3araht/giabalanai/readme.md

<p align=center>
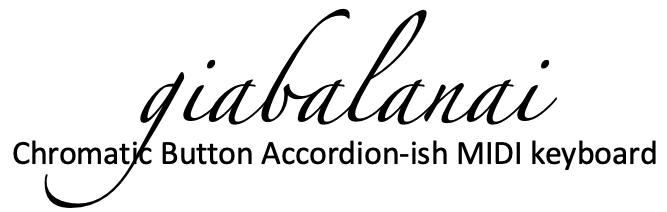
[picture p1: pictures/giabalanai_logo.png]
giabalanai_logo

</p>

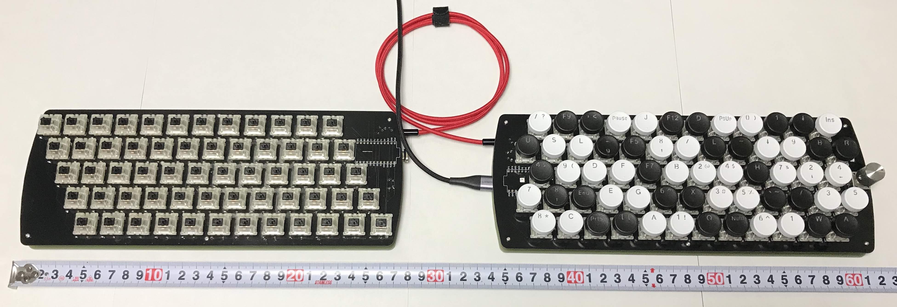
[picture p2: pictures/giabalanai_overview.jpg]
giabalanai overview


# giabalanai キーボード

✳︎ こちらは Pro Micro 版の giabalanai シリーズについてのページです。 [Raspberry Pi Pico 版の giabalanaipico シリーズにはこちら](https://github.com/3araht/giabalanaipico)を参照ください。

giabalanai キーボードは蛇腹もレジスタスイッチも無いシンプルデザインのクロマチックボタンアコーディオンチックな MIDI キーボード （60 ベース + C-system 62 鍵 = 38 音） です。
giabalanai は PC / Mac / iPad / iPhone で動作します。
（Android でも動作するそうです。ELEKIT（イーケイジャパン）さん、情報シェアいただきありがとうございます。）

コネクタが Lightning タイプの iPad や iPhone で使う場合、下記に示すアダプターを使って電源供給しながら使えることを確認しています。
iPad や iPhone で giabalanai を使う場合には電源が必要ですので、必ず "[Lightning - USB 3カメラアダプタ](https://www.apple.com/jp/shop/product/MK0W2AM/A/)" をお使いください。
"Lightning - USBカメラアダプタ" では電源供給ができません。

なお、USB-C タイプの iPad Air 4th Gen で試したところ、電源供給なしに問題なく動作させることができました。

ロータリーエンコーダは長押しでモード切り替えレイヤーへ。短押しでミュート切り替え、回転させるとシステム音量の調整に使用することが可能です。

# 外観および使用例
これらの動画 ([video1](https://youtu.be/EOIqms4lRcw), [video2](https://youtu.be/-KNHJdDH71s)) をご覧ください。

[こちら](https://youtu.be/hDas2LR00f4) は蛇腹談義のジングル(https://www.youtube.com/watch?v=WSVRJk6kDiM) を弾こうとしている様子です。

[私の YouTube チャンネル](https://www.youtube.com/channel/UC0zYtYMoxb0P7S8DPAkl0zA/) も併せてご覧ください。

ユニゾン機能の演奏例をGHEIMさんがUPされています。[こちら](https://twitter.com/GHEIM_2236/status/1382292767863296003?s=20&t=EltwkhD1qZg6FOf8UqGBdw)をご覧ください。

# キーボードキット
## ラインナップ
全部で7通りのバリエーションがございます。

|名前 | 説明 |
|---|---|
| giabalanai | 左手側が60鍵（伴奏用）右手側が62鍵盤（C-System）＋ロータリーエンコーダーが取り付け可能なモデル。|
| giabaLEnai | giabalanai の右手側だけ版|
| giabaRInaix2 | giabalanai の左手側のキーボードを2つ連結したモデル。ロータリーエンコーダーはありませんが、120キー全てが独立しているので自由にキー配置を変更できます（ソフト変更必要）。バンドネオン奏者の方、クロマトーン を演奏される方にはお勧め。|
| giabaRInai | giabalanai の左手側だけ版。giabaLEnai 持っているけどやっぱり左手側も欲しいという方向け。|
| giabalanaipico | giabalanai の Raspberry Pi Pico 版。右手側鍵盤が全て独立しました。また、レジスタスイッチも使えるようになりました。|
| giabaLEnaipico | giabalanaipico の右手側だけ版|
| giabaRInaipico | giabalanaipico の左手側だけ版。giabaLEnaipico 持っているけどやっぱり左手側も欲しいという方向け。|

giabalanai キーボードキットは遊舎工房さん、BOOTHでお求めいただけます。
[遊舎工房 販売ページへのリンクはこちら](https://yushakobo.jp/)。
遊舎工房さんでは、 [giabalanai](https://yushakobo.jp/shop/consign_giabalanai/) 、 [giabaLEnai](https://yushakobo.jp/shop/consign_giabalenai/) がお求めいただけます。

[BOOTH 販売ページへのリンクはこちら](https://3araht.booth.pm/)。
BOOTH では、全てお求めいただけます。

# ファームウェア

giabalanai は QMK firmware を使っています。下記からダウンロードできます:
[QMK - giabalanai directory](https://github.com/qmk/qmk_firmware/tree/master/keyboards/giabalanai)。

もしくは、こちらのコンパイル済の [hex file](https://github.com/3araht/giabalanai/blob/main/giabalanai_3araht_hex.zip) をお使いください （RGB_LIGHTING 有効）.

# ビルドガイド

[日本語ビルドガイド](https://github.com/3araht/giabalanai/blob/main/docs/build.md)

# コンタクト先:
Twitter と YouTube はじめました。
http://twitter.com/3araht
https://www.youtube.com/channel/UC0zYtYMoxb0P7S8DPAkl0zA/

## その他
#### giabalanai の名前の由来
アコーディオンの蛇腹が無いところから来ています（ジャバラナイ）。
giabaLEnai （ジャバレナイ）　は蛇腹に加えて左手側キーボード（LEft）がないこと、giabaRInai （ジャバリナイ）は右手側キーボード（RIght）がないこと、giabaRInaix2 は giabaRInai の2つ版、ということを示しています。

一応先祖はイタリア出身という設定なので、イタリア語表記を使っています。
そのため、 *jabaranai* ではなく giabalanai になっています。
<!--- not jabaranai but giabalanai ジャバラナイの名前の由来 -->

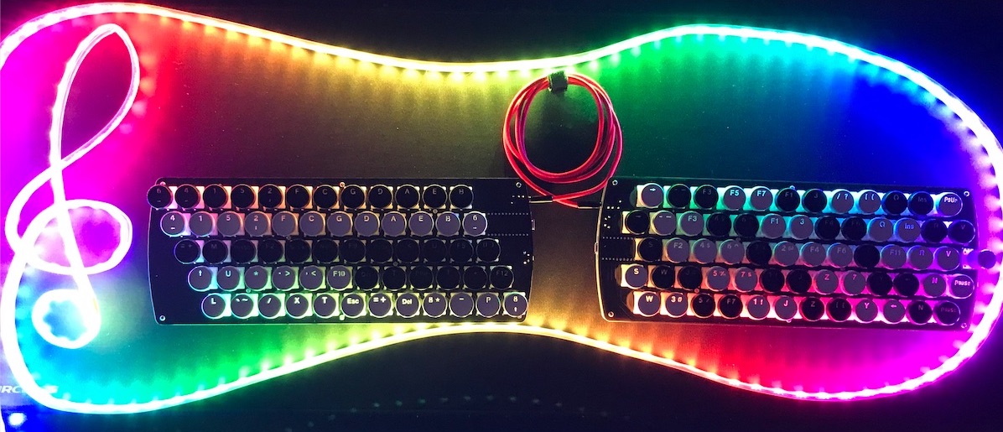
[picture p3: pictures/giabalanai_lighting2.jpg]
giabalanai lighting


# giabalanai keyboard

✳︎ This page is about giabalanai series, the Pro Micro version. For [giabalanaipico series, the Raspberry Pi Pico version, check here.](https://github.com/3araht/giabalanaipico)

giabalanai keyboard is a simple-design Chromatic Button Accordion-ish MIDI keyboard (60 bass + C-system 62 keys = 38 notes) that doesn't have bellows nor register switches.
giabalanai works with PC, Mac, iPad, and iPhone.
(It works with Android as well. Thanks to @elekit_official for sharing the info.)

When using it with iPad or iPhone, it works when the below adapter is used with a power supply. The power supply is necessary to use giabalanai on iPad and iPhone. Make sure to use "[Lightning to USB 3 Camera Adapter](https://www.apple.com/shop/product/MK0W2AM/A/)", not "Lightning to USB Camera Adapter."

It would work with [USB-C Digital AV Multiport Adapter](https://www.apple.com/shop/product/MUF82AM/A/) for the USB-C type iPads ~~( Since I don't have the latest iPad, it is not confirmed ).~~

(2021/04/08 added. Confirmed with an iPad Air 4th Gen, which has USB-C port, it worked without the power supply.)

A rotary encoder can be used to change the settings of giabalanai by long-pressing the push-button of the encorder, mute/unmute by clicking, and adjusting the system volume of your computer by rotating the encoder.

# How it looks & how it works
Check these short videos ([video1](https://youtu.be/EOIqms4lRcw), [video2](https://youtu.be/-KNHJdDH71s)) to see how it looks & how it works.

Here's another [video](https://youtu.be/hDas2LR00f4), trying to play (pardon my poor playing skills) a theme song of Giabala-Dangi (https://www.youtube.com/watch?v=WSVRJk6kDiM).

Check [my YouTube channel](https://www.youtube.com/channel/UC0zYtYMoxb0P7S8DPAkl0zA/) for more videos.

# Keyboard kit
## Lineup
There are total 7 types:

|Name | Notes |
|---|---|
| giabalanai | 60 keys on the left-hand side for playing chords and 62 keys ＋ optional rotary encoder on the right-hand side for playing the melody (C-System)|
| giabaLEnai | The right-hand side only version of giabalanai |
| giabaRInaix2 | Two pcs of the left-hand side of giabalanai. Rotary Encoder is not applicable. All 120 keys are isolated, so there is more flexibility for customizing the key layout (software modification is required). Bandoneon and Chromatone players might be interested in this model.|
| giabaRInai | The left-hand side only version of giabalanai. For our friends who have giabaLEnai but want to have the left-hand side later on.|
| giabalanaipico | Raspberry Pi Pico version of giabalanai. All keys on the right side keyboard are now independent. Register switches are now available. |
| giabaLEnaipico |  The right-hand side only version of giabalanaipico |
| giabaRInaipico | The left-hand side only version of giabalanaipico. For our friends who have giabaLEnaipico but want to have the left-hand side later on.|

The keyboard kit is available from [Yushakobo](https://yushakobo.jp/shop/consign_giabalanai/), or from [BOOTH](https://3araht.booth.pm/).

Click [here](https://www.tenso.com/en/static/lp_shop_booth) for BOOTH overseas shipping!

Both [giabalanai](https://yushakobo.jp/shop/consign_giabalanai/) and [giabaLEnai](https://yushakobo.jp/shop/consign_giabalenai/)  are available from Yushakobo.
All the models are available from [BOOTH](https://3araht.booth.pm/).

# Firmware

The giabalanai uses QMK for its firmware. The codes for it is available here:
[QMK - giabalanai directory](https://github.com/qmk/qmk_firmware/tree/master/keyboards/giabalanai).

Or, use this pre-compiled [hex file](https://github.com/3araht/giabalanai/blob/main/giabalanai_3araht_hex.zip) for your convenience (RGB_LIGHTING enabled).

# Build Guide

[Japanese Build Guide](https://github.com/3araht/giabalanai/blob/main/docs/build.md)
Try [Google Translated guide](https://translate.google.com/translate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) for your language preferences. Trust me, it works quite well, more than expected.

# Contact
If you need any help, you know where to find me.
http://twitter.com/3araht
https://www.youtube.com/channel/UC0zYtYMoxb0P7S8DPAkl0zA/

## Miscellaneous
#### Origin of the name: giabalanai
When you pronounce giabalanai, it sounds like "蛇腹無い" in Japanese = *bellows-less*, which represents the keyboard.
Much easier for others: giabaLEnai = not only bellows-less but missing LEft-hand side, giabaRInai = not only bellows-less but missing RIght-hand side, and two sets of giabaRInai is giabaRInaix2.

Well, the ancestor of this keyboard is located in Italy ;-) so the Italian spelling method is used.
That's why it is not *jabaranai* but giabalanai.
<!--- not jabaranai but giabalanai ジャバラナイの名前の由来 -->
