3araht/giabalanai/docs/old/20200923.md

**お詫びと確認のお願い**  
2020/9/23 に、giabalanai キーボード キットをご購入いただいた方から、ダイオードの数が足りないとのご連絡をいただきました。
その方への不足分の発送、Twitterで今回の件についてのご報告、遊舎工房さんの在庫分の確認を行いました。
問題の可能性があるキットは、 9/18 〜 9/23 までにご購入された方のキットになります。9/23 に確認できた遊舎工房さんの在庫は問題なかったのですが、単純計算しますと確率的にもう 1 〜 2 セット同様の問題のセットが流出してしまった可能性がございます。
今回ご指摘下さった方にこの場で改めてご迷惑をおかけしたことをお詫び申し上げます。

また、9/18 〜 9/23 までにご購入された方皆様には、まず最初に員数の確認をお願い致します。
もし員数不足が見つかりましたら、まずは遊舎工房さんにご連絡ください。皆様の個人情報につきましては取り扱いに十分注意し、不足分を最短でお送りするように致します。
ご不便・ご迷惑おかけして申し訳ございません。どうぞよろしくお願い申し上げます。

今後の防止策と致しましては、タブルチェックの強化および予備の同梱により最悪員数が下振れしても必要数量を下回らないように致します。
