3araht/giabalanai/pictures/20200927_giabalanai_Colemak_layout.png

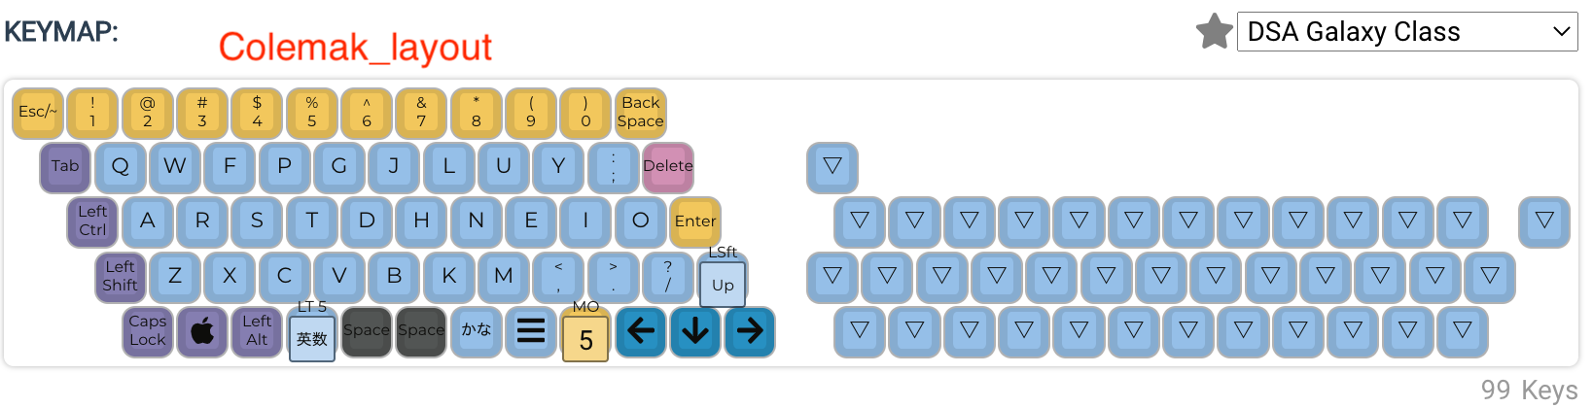
pictures/20200927_giabalanai_Colemak_layout.png
