3araht/giabalanai/pictures/20200927_giabalanai_FN_layer.png

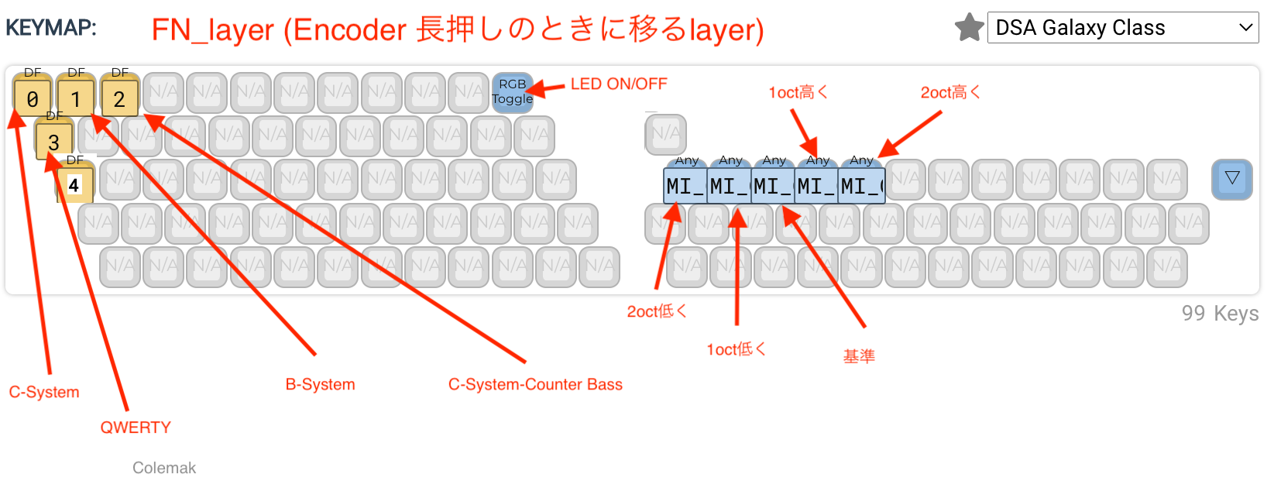
pictures/20200927_giabalanai_FN_layer.png
