3araht/giabalanai/pictures/20201130_giabalanai_FN_layer.png

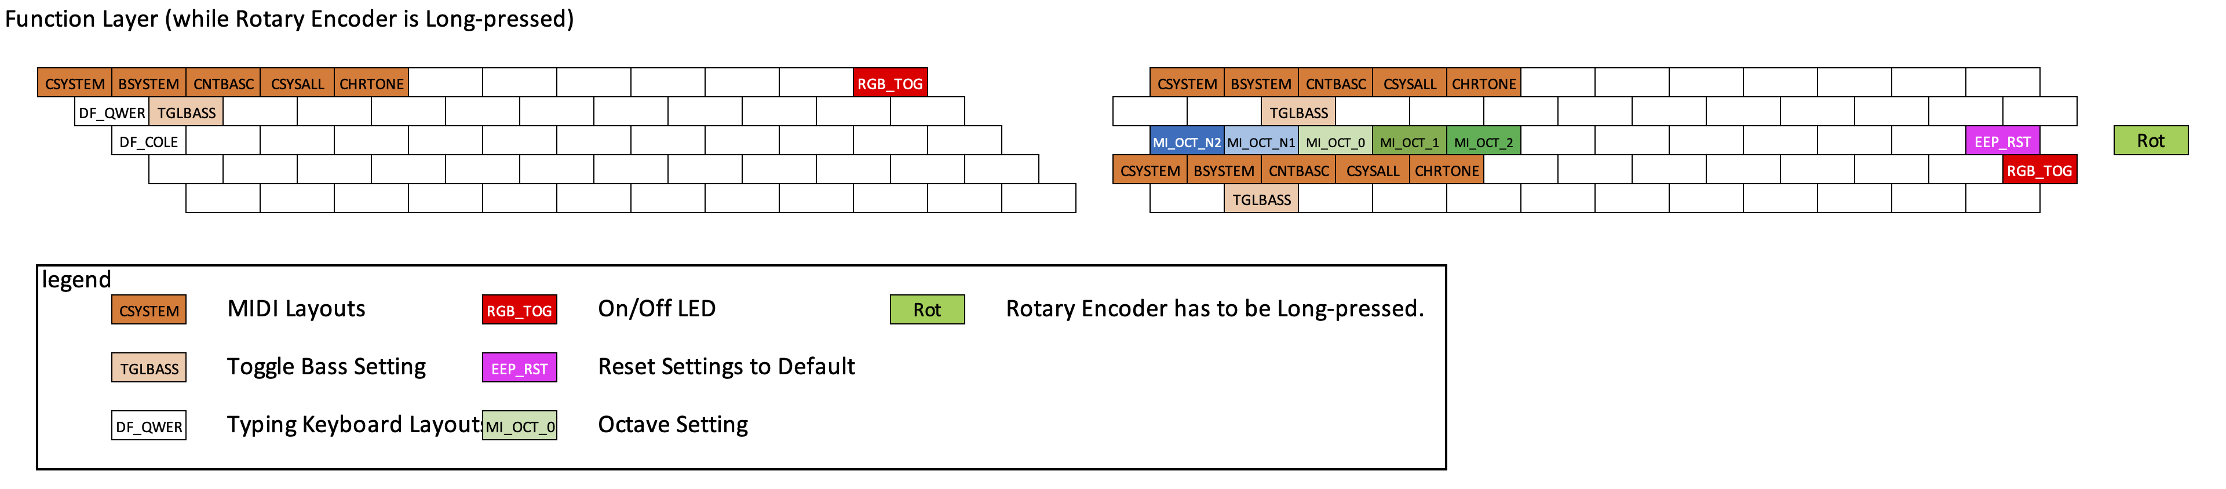
pictures/20201130_giabalanai_FN_layer.png
