3araht/giabalanai/pictures/20201130_giabalanai_notes_layout_3araht.png

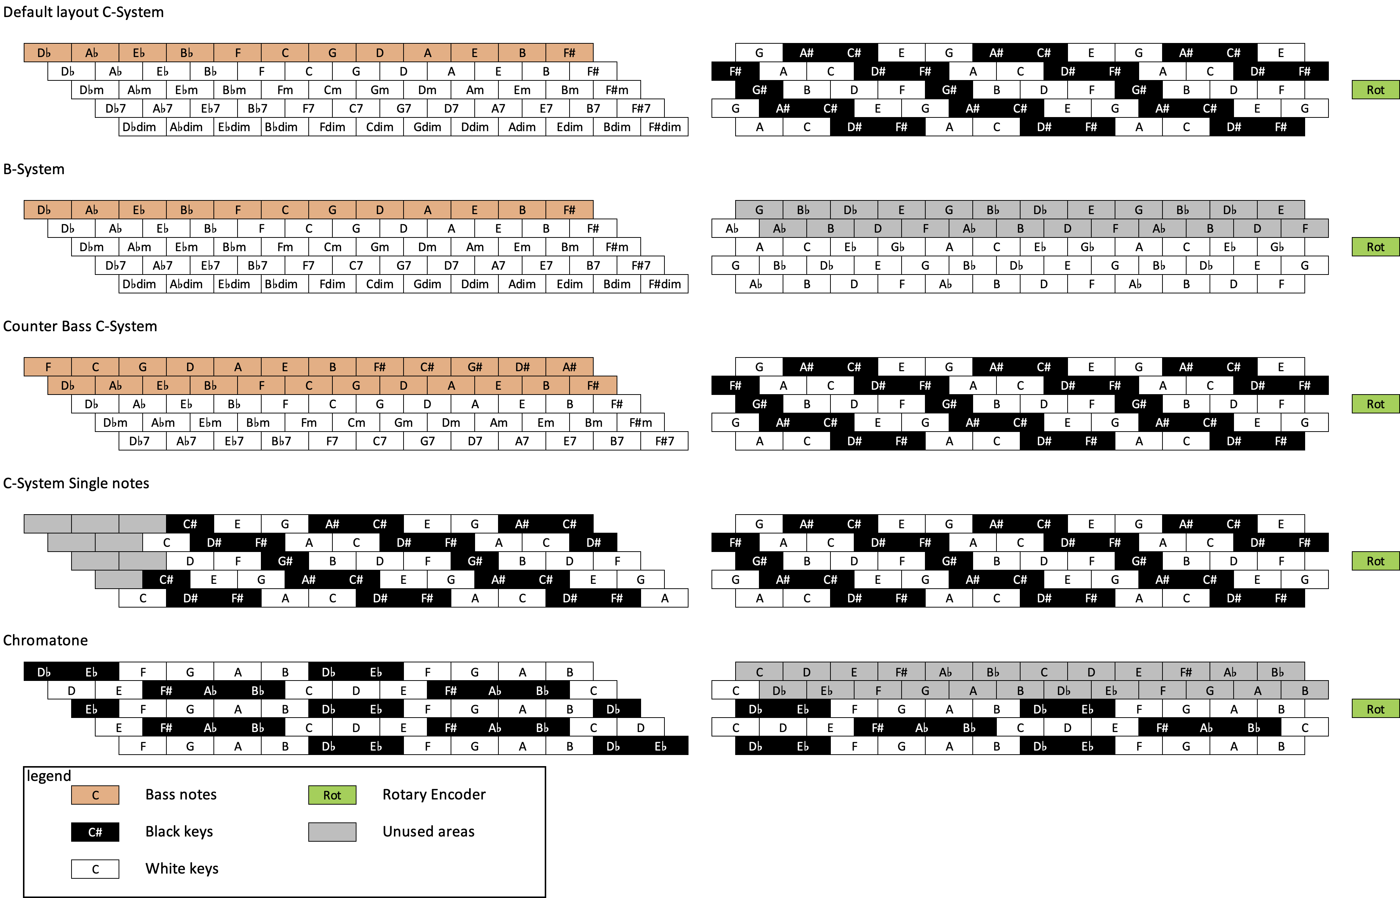
pictures/20201130_giabalanai_notes_layout_3araht.png
