3araht/giabalanai/pictures/20201205_giabalanai_FN_layer.png

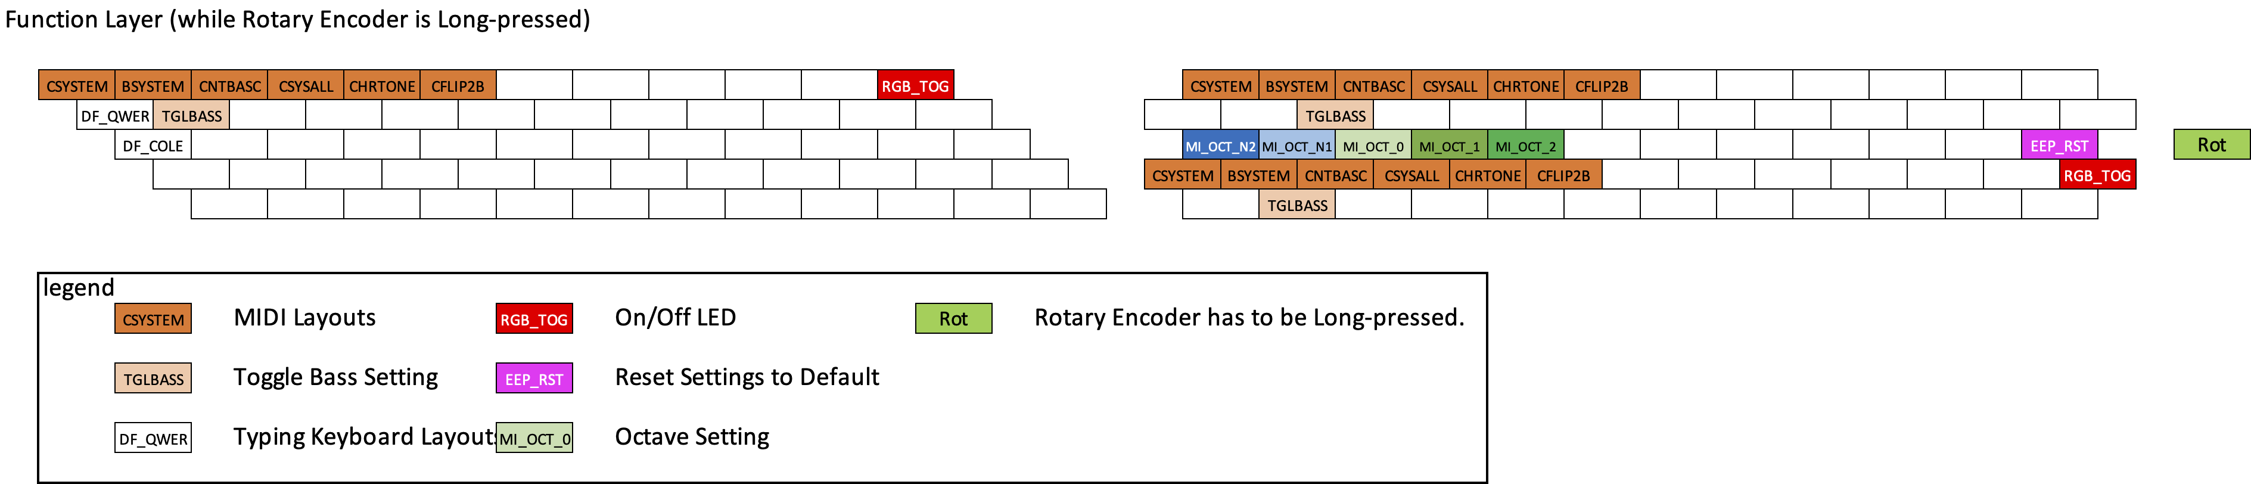
pictures/20201205_giabalanai_FN_layer.png
