3araht/giabalanai/pictures/20220220_giabalanai_FN_layer.png

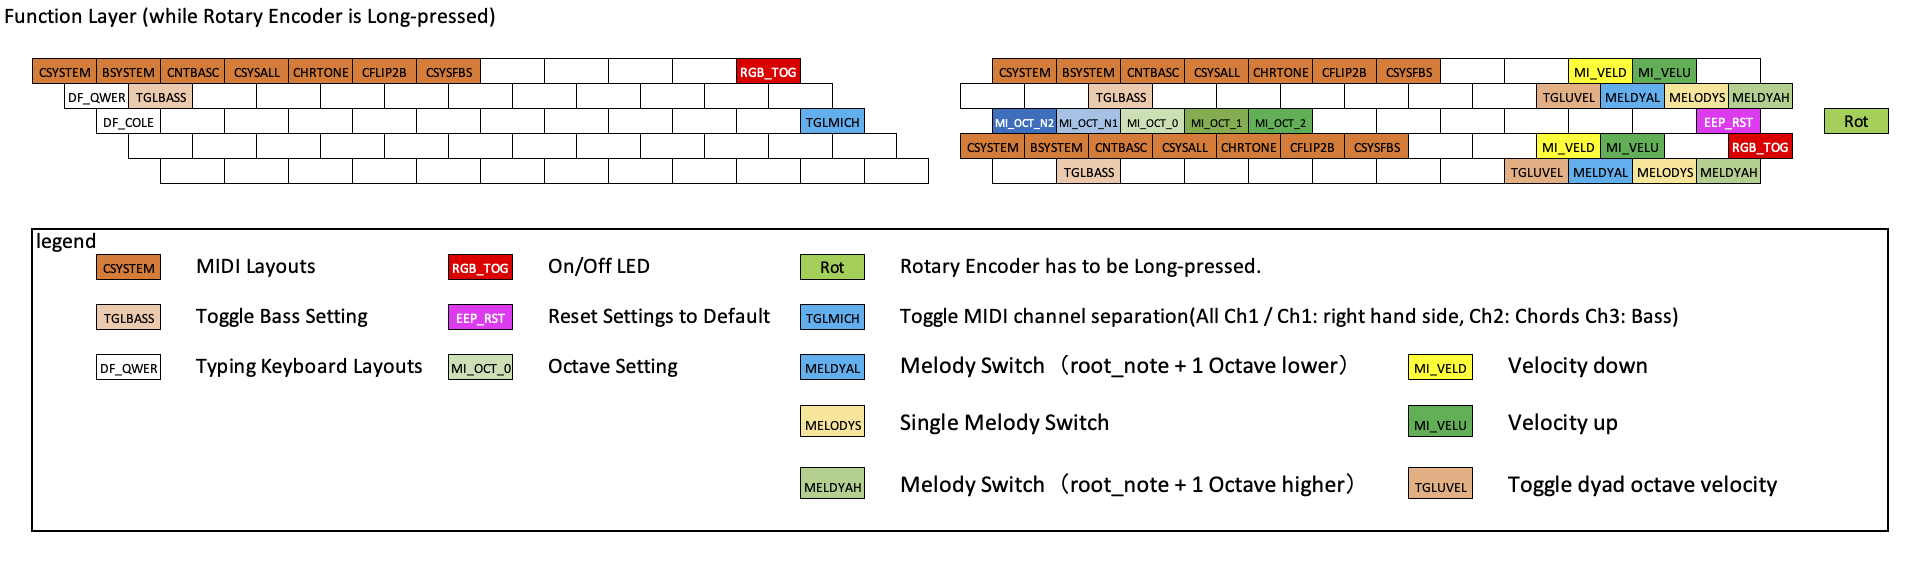
pictures/20220220_giabalanai_FN_layer.png
