3araht/giabalanai/pictures/20220220_giabalanai_notes_layout_3araht.png

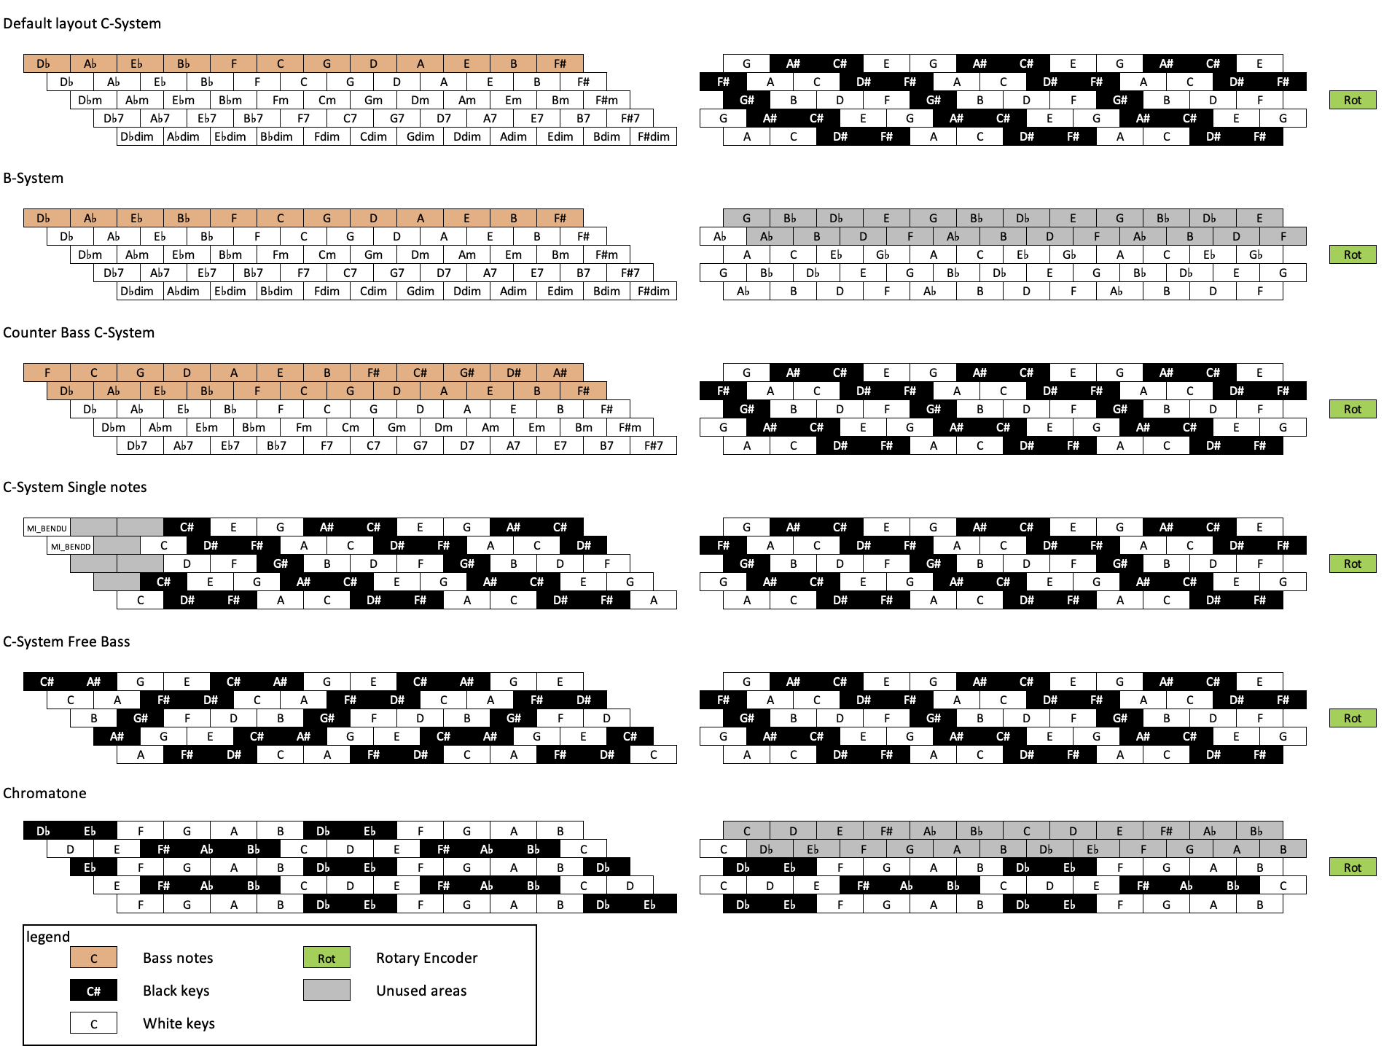
pictures/20220220_giabalanai_notes_layout_3araht.png
