3araht/giabalanai/pictures/20220807_giabalanai_FN_layer.png

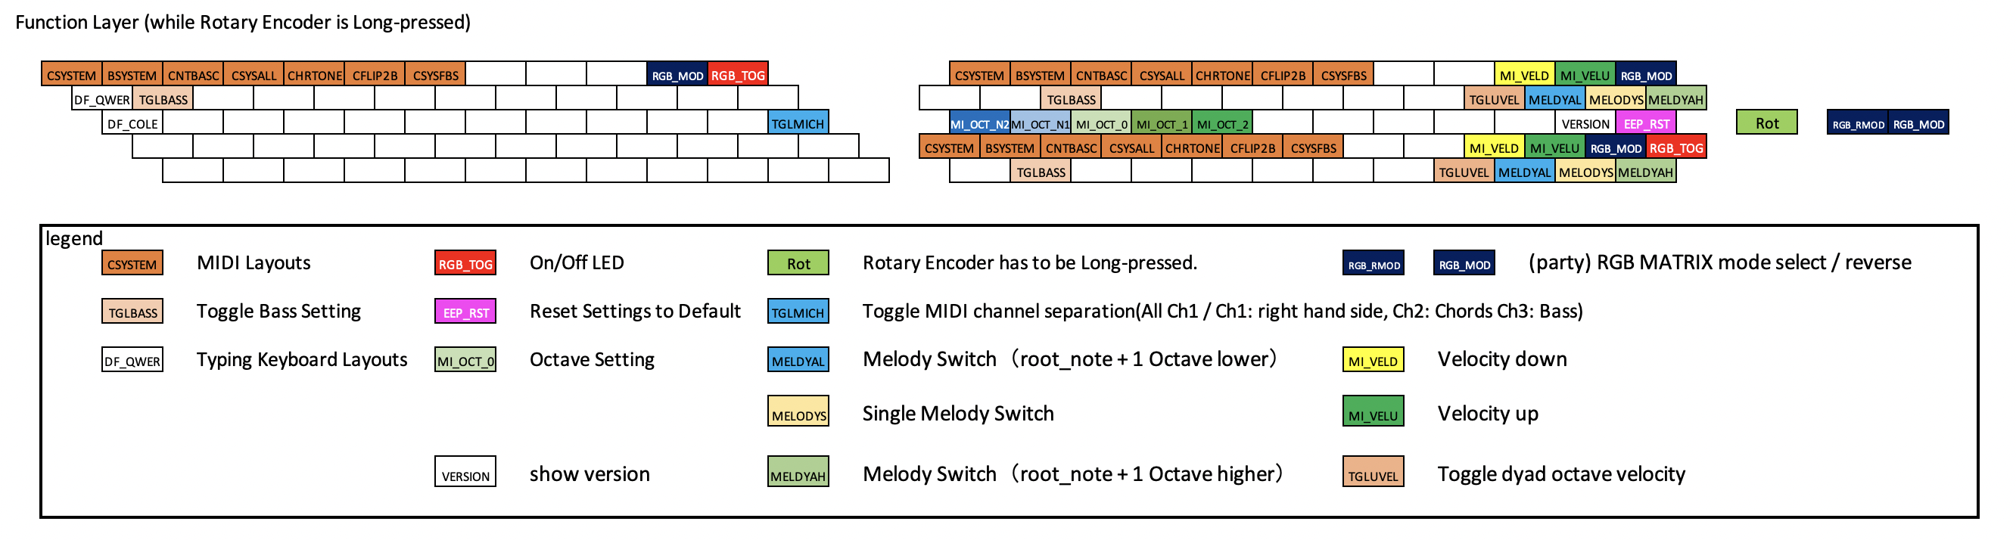
pictures/20220807_giabalanai_FN_layer.png
