3araht/giabalanai/pictures/giabalanai16_9.jpg

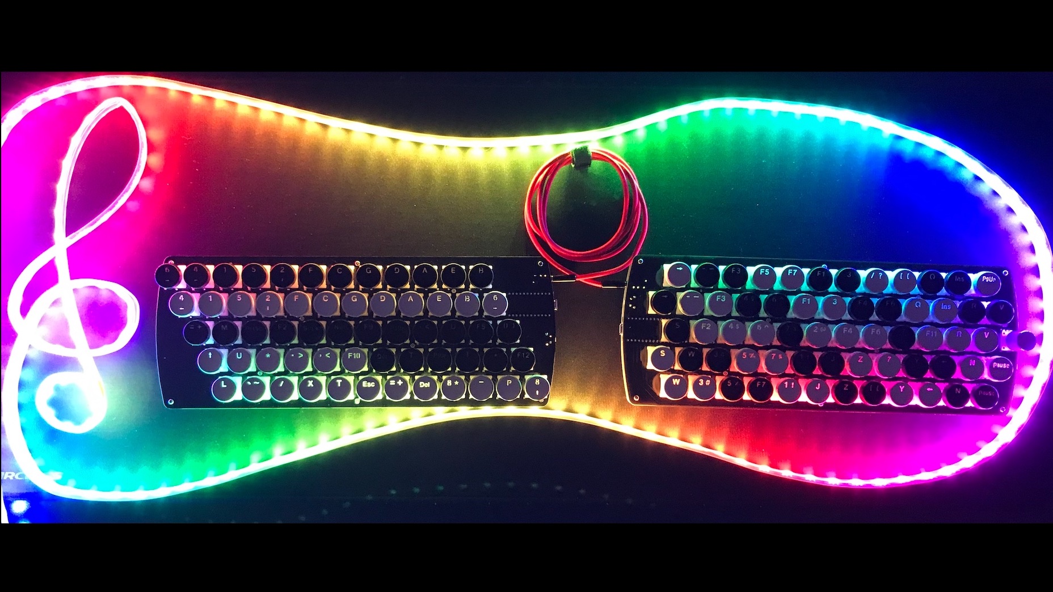
pictures/giabalanai16_9.jpg
