3araht/giabalanai/pictures/giabalanai_notes_layout_3araht.png

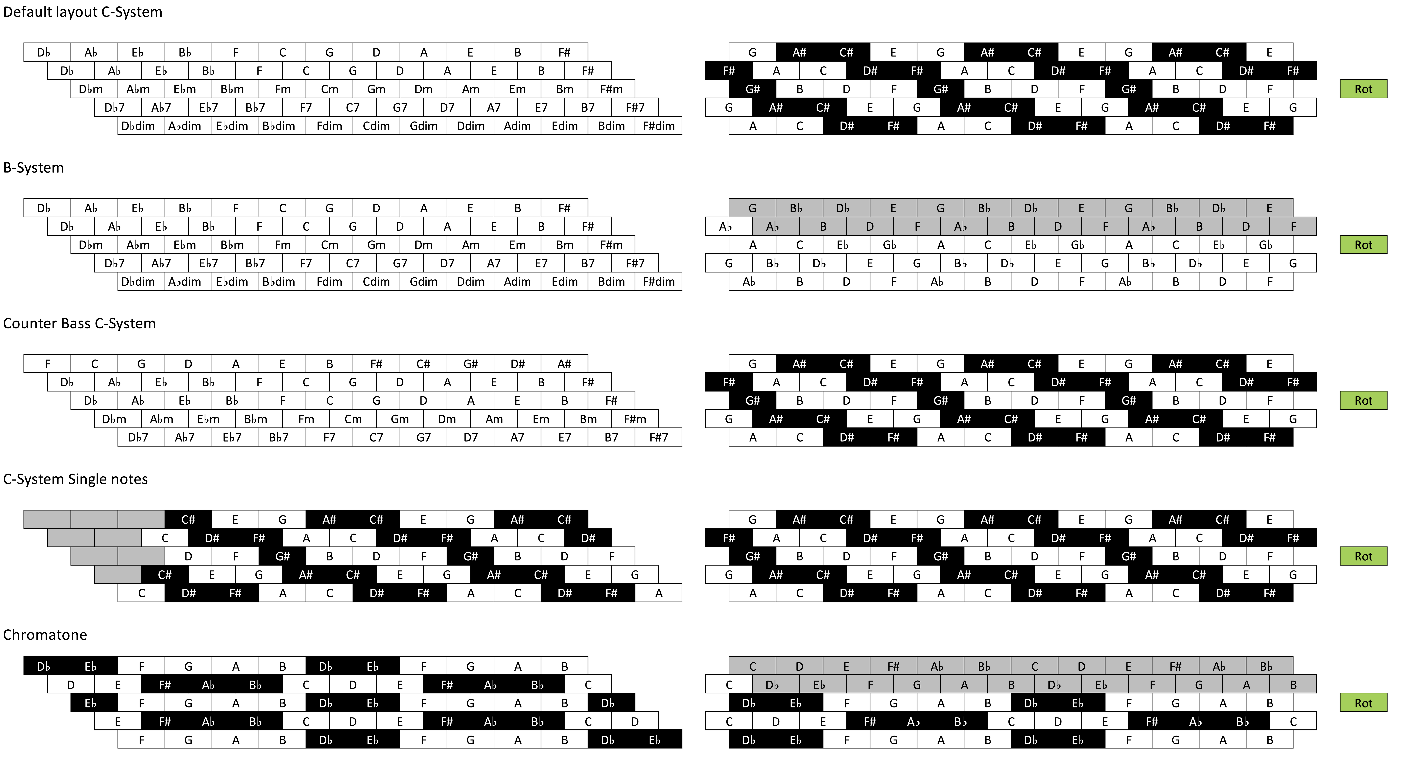
pictures/giabalanai_notes_layout_3araht.png
