3araht/giabalanai/pictures/giabalanai_overview_square.jpeg

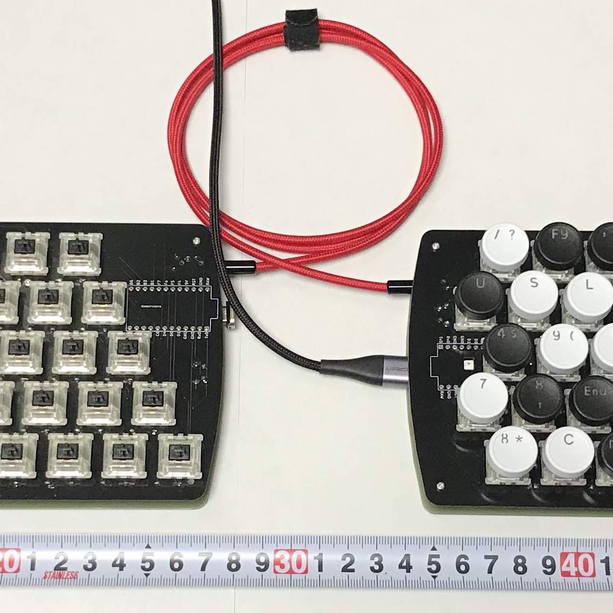
pictures/giabalanai_overview_square.jpeg
