3araht/giabalanai/pictures/giabaRInai_overview.jpeg

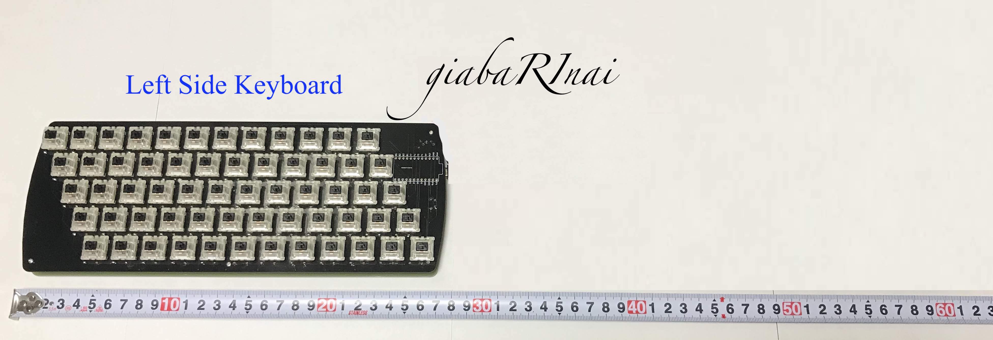
pictures/giabaRInai_overview.jpeg
