3araht/giabalanai/pictures/giabaRInaix2.jpeg

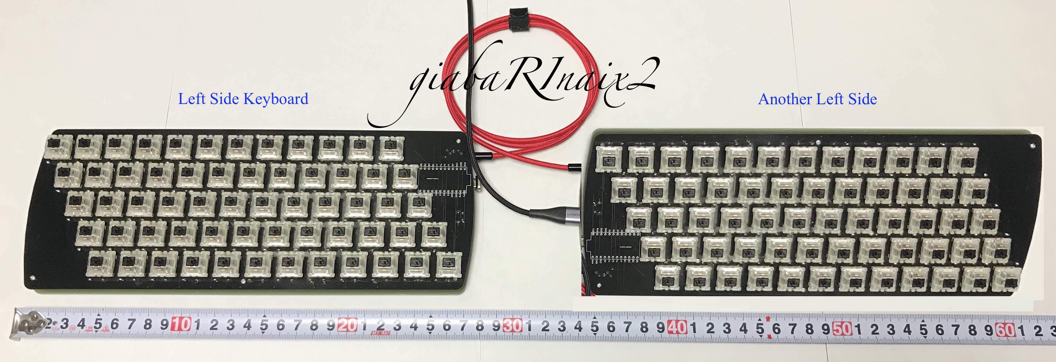
pictures/giabaRInaix2.jpeg
