3araht/giabalanai/pictures/hexDownload.png

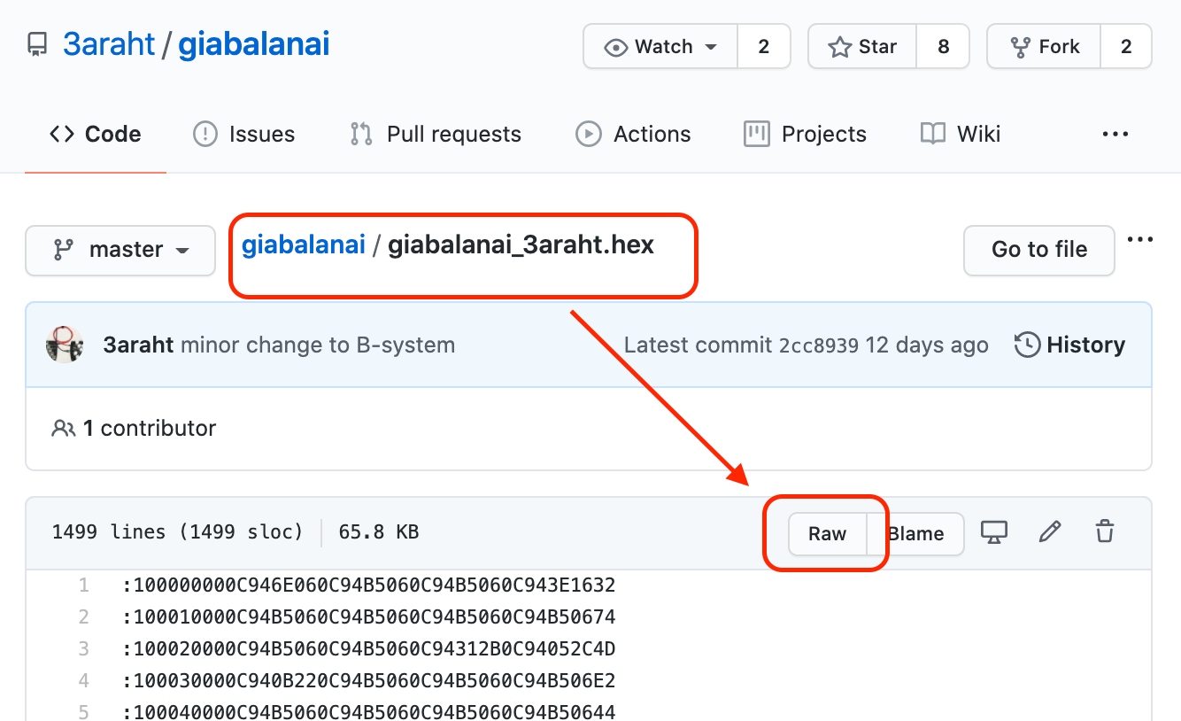
pictures/hexDownload.png
