3araht/giabalanai/docs/build_r01.md

# giabalanai Build Guide  〜 rev.01 用 〜
*rev.02用のビルドガイドは[こちら](https://github.com/3araht/giabalanai/blob/main/docs/build.md)*

**一度すべて読んでから組み立てることをお勧めします。**

## 0 パーツの確認、各部品の実装面の整理
### キット付属品

| パーツ名 |  個数  |  備考  |
|---|---|---|
|左手側基板|1枚|キーが平行四辺形に5行12列配置されているもの。|
|右手側基板|1枚|キーが上から12列、13列、12列、13列、12列配置されていて、右端にはエンコーダーが配置されているもの。|
|ボトムプレート|2枚|左手側基板も右手側基板も同じボトムプレートを使います。|
|M2 スペーサー |20個|左右各10個|
|M2 ネジ|40個|左右各20個|
|クッションシール|10個|左右各5個|
|TRRSジャック|2個|左右の基板を繋ぐTRRSケーブル用|
|リセットスイッチ|2個|ファームウェアを書き込むときに使います。|
|ダイオード 1N4148|99個|左手側は60個、右手側は38個＋エンコーダ用1個|

右手側は62ボタンありますが、そのうち24ボタンは音が重複しているボタンなので、ダイオードは24個少なくてよく、右手側は38個あれば良い事になります。
そこにエンコーダー分を加えて右側はダイオードを39個使います。
キットには123個入ってますが、24個は使いません。

### 別途用意いただく必要のあるもの

| パーツ名 |  個数  |  備考  |
|---|---|---|
|[Pro Micro （コンスルー付き）](https://yushakobo.jp/shop/promicro-spring-pinheader/)|2個|ファームウェア なし をお選びください（別途書き込みます）。|
|キースイッチ(CherryMX 互換品)|122個|左手側60個＋右手側62個。|
|MX対応キーキャップ|122個|1U、左60個＋右62個。（5pinタイプ推奨） |
|[TRRSケーブル](https://yushakobo.jp/shop/trrs_cable/)|1本|AUXケーブルとも呼ばれている3.5mmオーディオ用の4極ケーブル(左手側のLEDも発光させる場合は4極ケーブルが必須)。|
|[MicroUSBケーブル](https://yushakobo.jp/shop/usb_cable_micro_b/)|1本|Pro Micro 側のコネクタの耐久性が低いためマグネット式を推奨。左右の基板の Pro Micro にファームウェア書き込むときにとても便利です。|

### [Optional]別途用意いただく必要のあるもの

| パーツ名 |  個数  |  備考  |
|---|---|---|
|[ロータリーエンコーダ(ノブ付き)](https://yushakobo.jp/shop/pec12r-4222f-s0024/)|1個|右手側のキーボードに配置。音量調整＋ミュート用のロータリーエンコーダを取り付ける場合は必要。|
|LED（SK6812mini）|123個|2の「Backlight RGB LED」を使う場合に必要。左60個＋右62個＋エンコーダ用1個。|

### オモテ面、裏面の実装物

**※ 部品の実装には順番があります。特に、Pro Micro、キースイッチ、エンコーダ、の実装は最後になりますので先に実装しないよう注意ください。
実装の順番はこの後の手順に従ってください。**

基板の裏面には、ダイオードの実装場所やキーボード名が印字されています。

左手側 オモテ面  
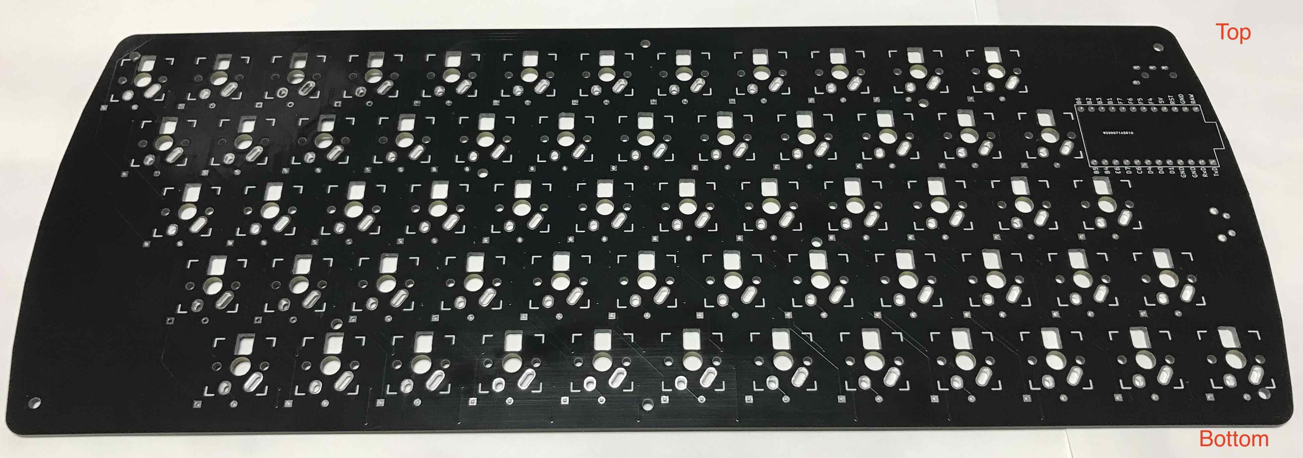
[picture p57: pictures/left_front_pcb.jpg]


左手側 裏面  
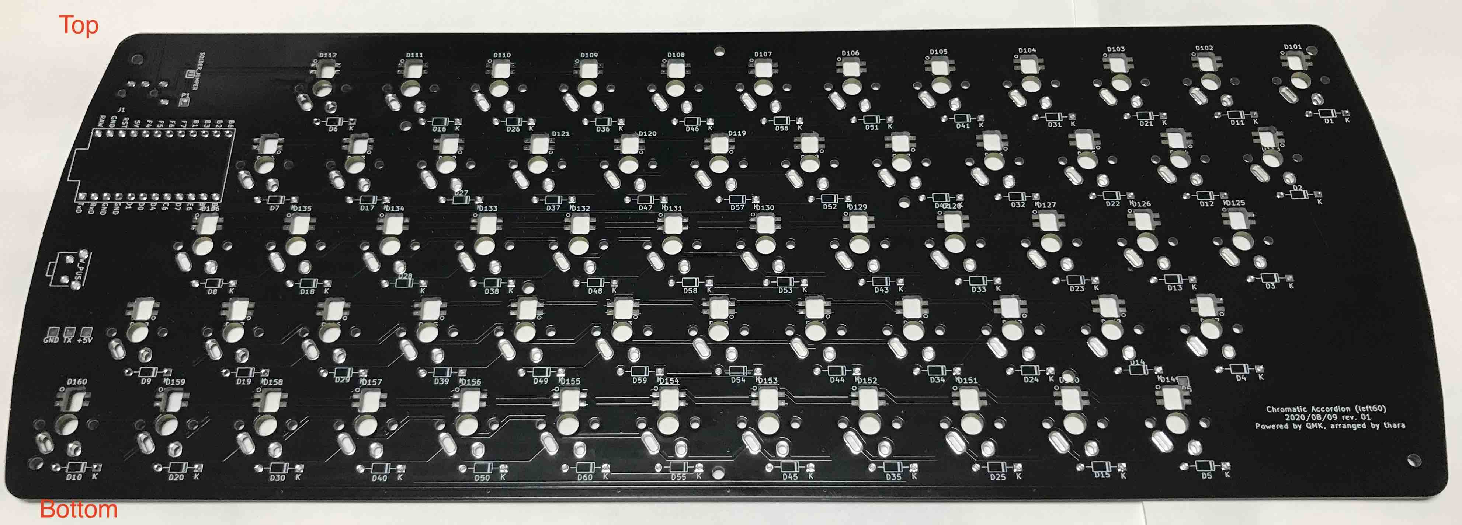
[picture p58: pictures/left_rear_pcb.jpg]


右手側 オモテ面  
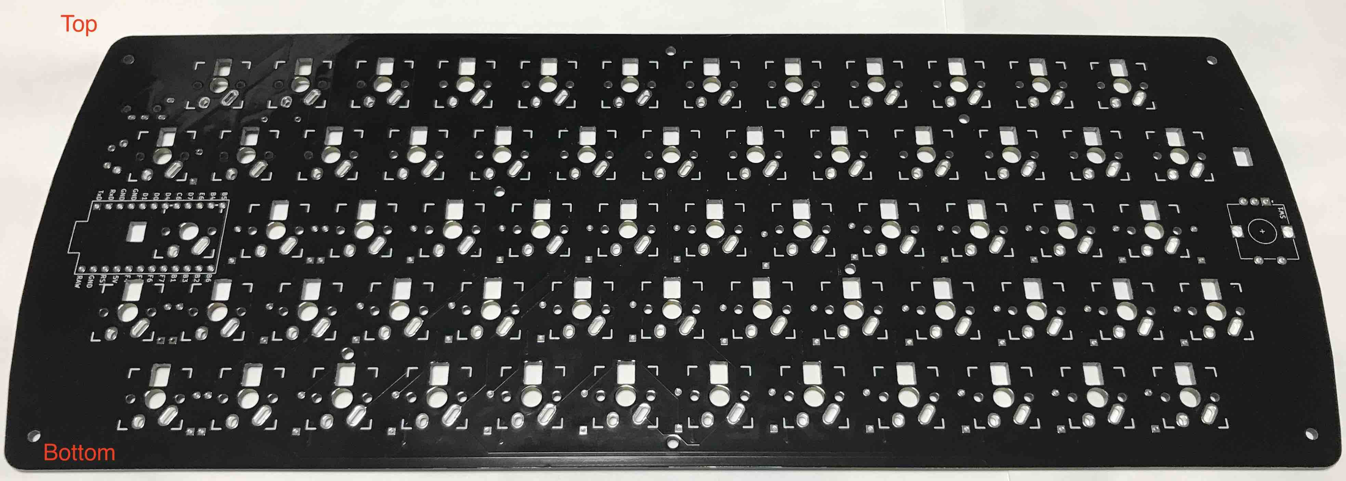
[picture p59: pictures/right_front_pcb.jpg]


右手側 裏面  
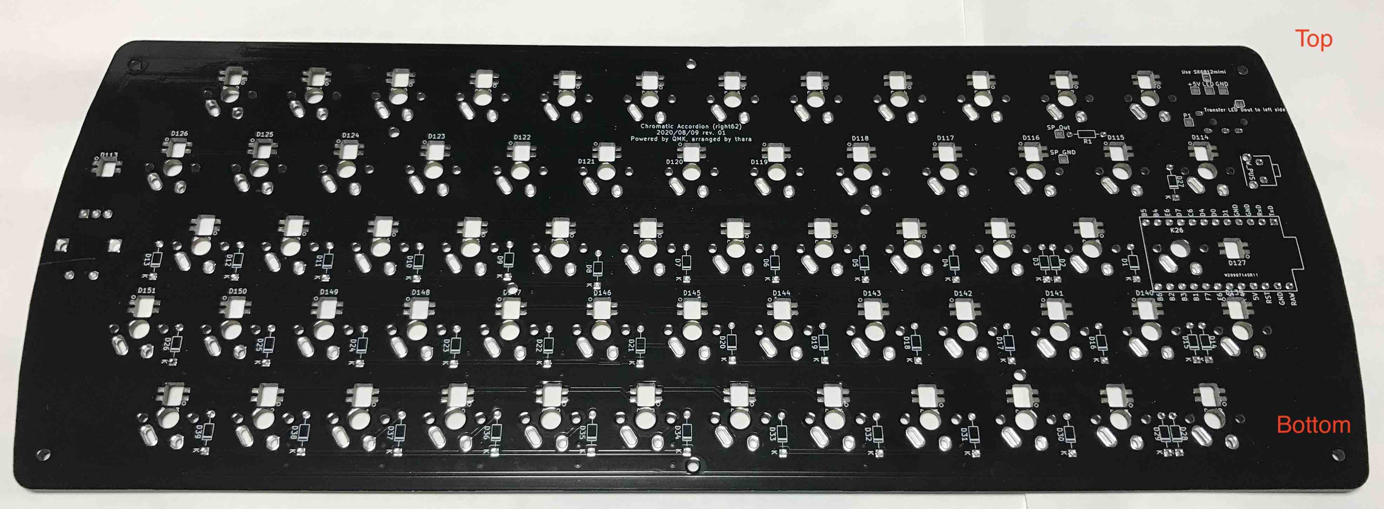
[picture p60: pictures/right_rear_pcb.jpg]


#### 裏面には次の部品を実装します
 - LED[Optional]
 - ダイオード
 - TRRSジャック
 - リセットスイッチ
 - Pro Micro

#### オモテ面には次の部品を実装します
 - キースイッチ
 - エンコーダ

## 1 ダイオードの取付け
キーの数が多いキーボードではMatrixという手法を使ってキーが押されたかどうか判断します。
キーが必ず1個ずつしか押されないと保証されているのであれば、このダイオードは不要なのですが、
和音を弾くことがあるので複数のキーを同時に押す場面が出てきます。
このとき、Matrixという手法で複数同時押しを正しく判断するためにこのダイオードが必要になります。
詳しい説明については、[こちら](https://docs.qmk.fm/#/how_a_matrix_works)などをご覧ください。

ダイオードには向きがあります。また、図のように足を曲げておきます。
ダイオードをつまんで両端の足を同時に曲げると図の右のように比較的ちょうどいい形になります。  
diode

キースイッチと干渉しないように、ダイオードは基板の裏面に実装します。
ダイオードの黒い線のほうが四角いフットプリント（Kと印字されている方, K はKathode（独）の頭文字らしいですが、黒（Kuro) の K で。）に合うように配置します。  
diode

足を曲げて基板に這わせてダイオードを仮止めします。  
diode

オモテ面から見た図  
diode

オモテ面から半田付けします。  
diode

足をニッパでカットします。  
diode

## 2 Backlight RGB LEDの取付け[Optional]
バックライト用のチップLED(SK6812mini)はPCBの裏面から実装します。向きに注意して穴に入れてください。
LEDの裏から見て、一番大きいパッド（5V）とシルク（印字の事）の○が同じ位置になります。
LEDはデータを直列に伝送する都合上、最上行はオモテ面からみて左から右、2行目は右から左、3行目はまた左から右に…と並んでいます（右手側の場合）。  
RGB_LED

このため、偶数行と奇数行のLEDの向きが違うので十分ご注意ください。
半田付けが軌道に乗った矢先に向きを間違えがちです。
その時のショックと言ったら。。。（経験者談）。  
RGB

温調半田ごてを使い、約220℃で半田付けします。温度が高いとLEDが壊れますので注意してください。
温調できない半田ごてではすぐに焦げます＆壊れます（これも経験者談）。

こてを斜めにして接触面積を広げるとやり易いという事がわかりました。  
RGB_LED

LEDは、右手側 Pro Micro の1番ピン（Tx）から右手側基板の左上のLEDから直列繋ぎにデータを伝達し、右手側基板上の63個のLEDを通過したデータはTRRSケーブルを通じて左手側基板上面からみて右上のLEDから直列繋ぎにデータを伝達します。

右手側基板および左手側基板の下図の位置を半田でジャンパします。

1、右手側基板の2箇所と、  
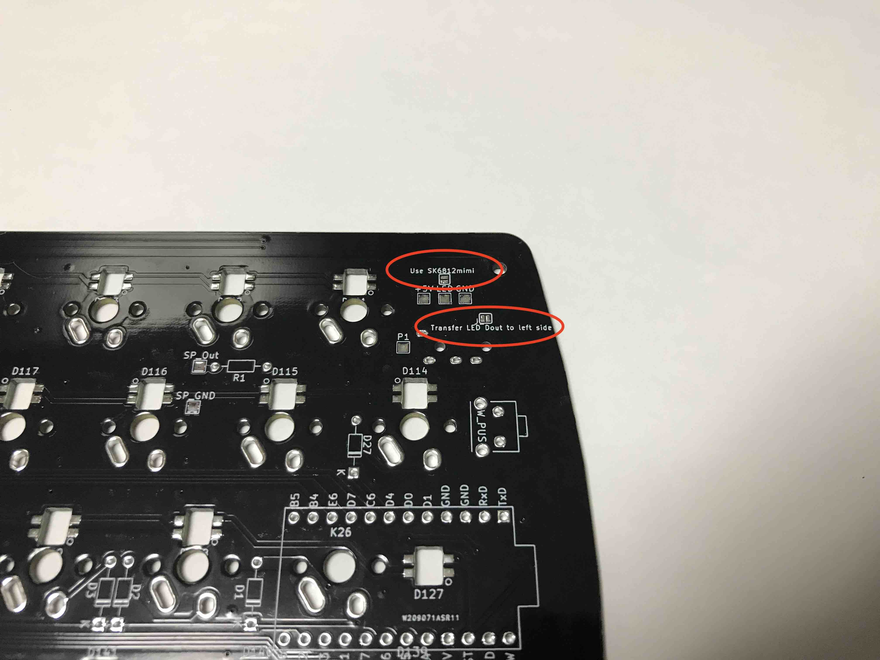
[picture p61: pictures/LED_right_jumper.jpg]
Jumper


2、左手側基板のここ。  
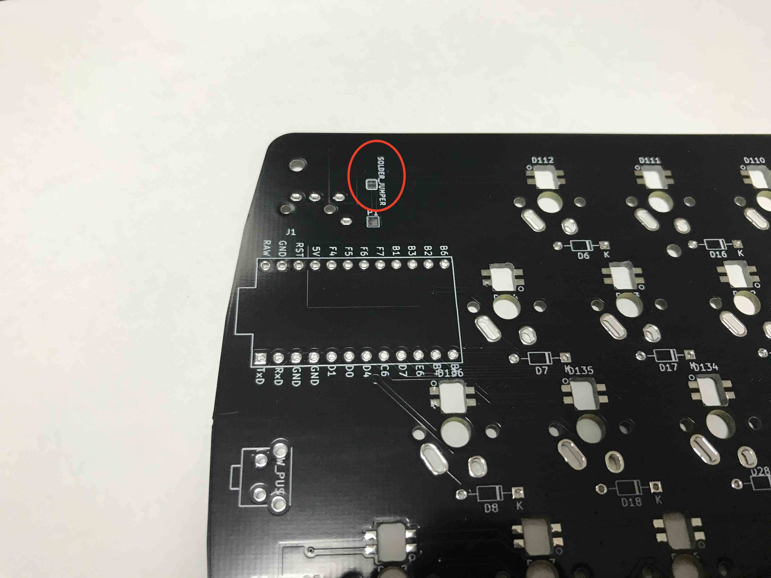
[picture p62: pictures/LED_left_jumper.jpg]
Jumper


LEDの情報は直列に伝送されますので、接続が途切れてしまうと正しくLEDが光らなくなります。

## 3 リセットスイッチとTRRSジャックの取付け
左右の基板共、白い四角い枠のシルクに沿って裏側に取り付けます。浮いたり曲がった状態で実装しないようにマスキングテープなどで予め仮止めしてから半田付けするとミスが少なくなります。  
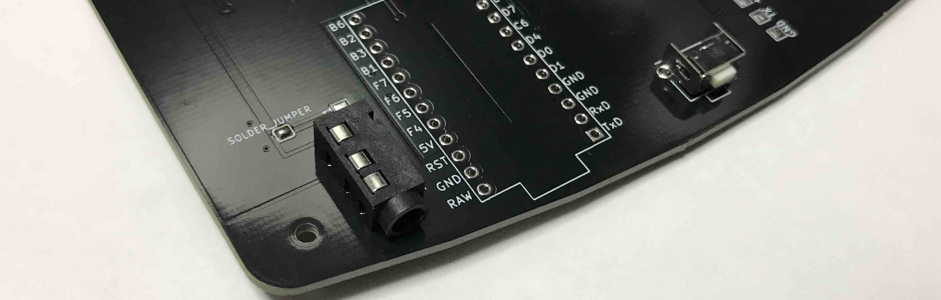
[picture p63: pictures/TRRS_ResetSW.jpg]
S_T


## 4 Pro Micro 用ピンヘッダの取付け
**※コンスルー（スプリングピンヘッダ）を使う場合はこの工程は不要です。**
白い四角い枠のシルクに沿って裏側にピンヘッダを取り付けます。
**この時点で Pro Micro を取り付けてはいけません。一度半田付けしてしまった Pro Micro を取り外すのは至難の技です。充分ご注意ください。**

## 5 キースイッチ、エンコーダ（Option）の取付け
**スイッチを取り付ける前に部品の取付けや半田付けができているか確認します。**  
（1 のダイオードは必ず済ませておいてください。）  

※スプリングピンヘッダを使用する場合は6と8の工程を先に行い、動作確認(下図のようにキースイッチ部をピンセットなどでショートさせ、MIDI機器を認識するソフトで音が出るか確かめる事)をすると失敗する可能性が減ります。  
switch

キースイッチをオモテ側からしっかり奥まで差し込みます。このとき、端子が曲がっていると実装穴に端子が入らないので注意してください。1行ずつキースイッチをしっかり差し込んでから半田付けしていった方が差し込み不良は減らせると思います。      
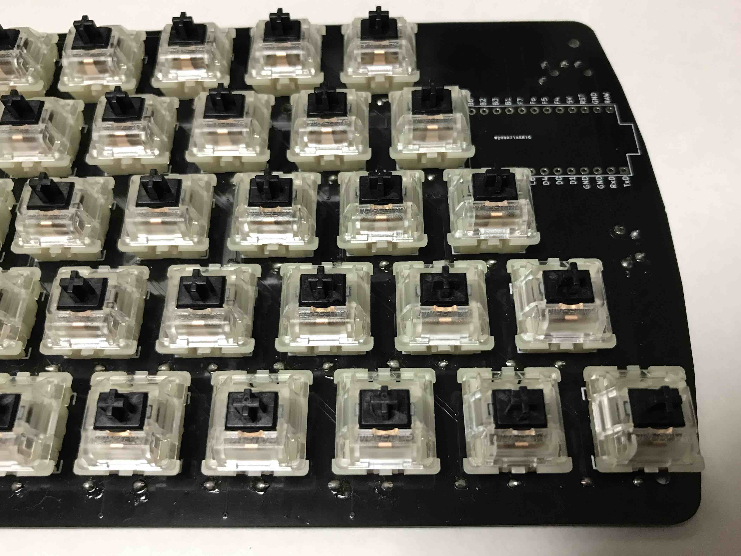
[picture p64: pictures/Keysw_front.jpg]
  
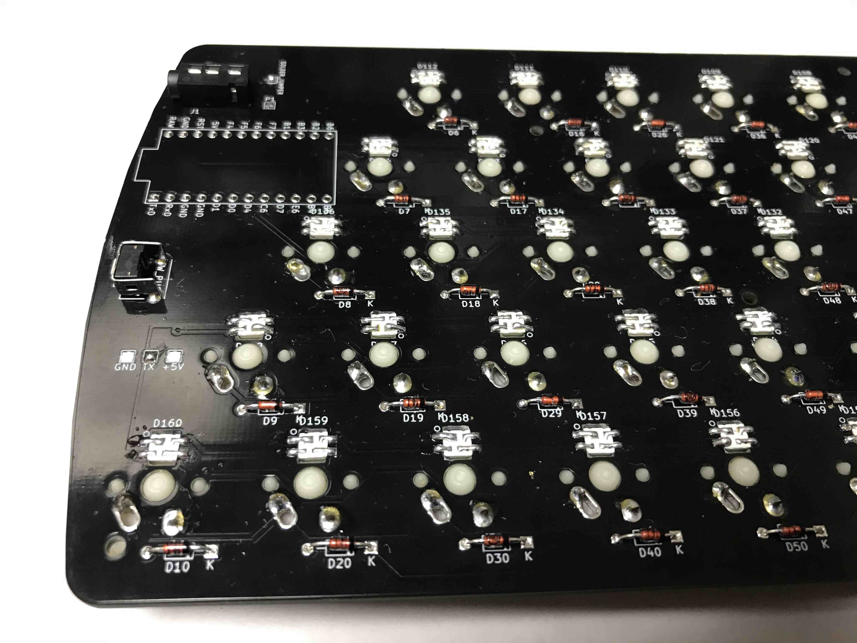
[picture p65: pictures/Keysw_rear.jpg]


## 6 Pro Micro の取付け
**作業前にPro MicroをUSBでPCと繋げて動作を確認しておきましょう。**
取り付ける前に半田忘れがないか確認します。
左右の基板とも Pro Micro を表にして取り付けられるようになります。
取り付けたときに Pro Micro の浮きがないか確認し、浮きがあれば Pro Micro下のスイッチの足を少しカットします。

※コンスルーを使う場合は Pro Micro 側のみを半田付けします。  
CT

コンスルーを斜めに半田付けしないように、基板の**裏面から**コンスルーを差しておいてピンが垂直になるようにします。
下図のように、Pro Micro 側(側面に空いている小さな穴が近い方)を上にして基板にコンスルーを差し込みます。
このとき、図のように、コンスルーの向きを揃えておきます（＝2つとも側面の小さな穴が空いている方向を揃えます）。  
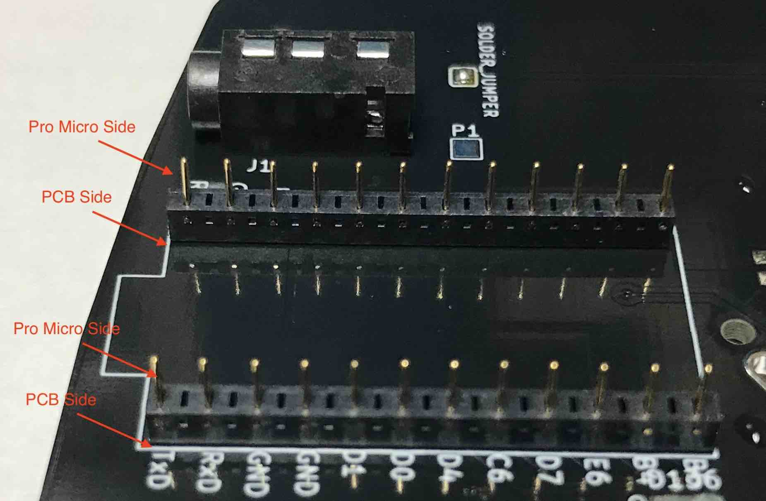
[picture p66: pictures/Con_through_onPCB.jpg]


*Pro Micro の上下の向きに注意。Pro Micro の TxD ピンが基板の TxD に刺さるように向きが合っているか確認します。  
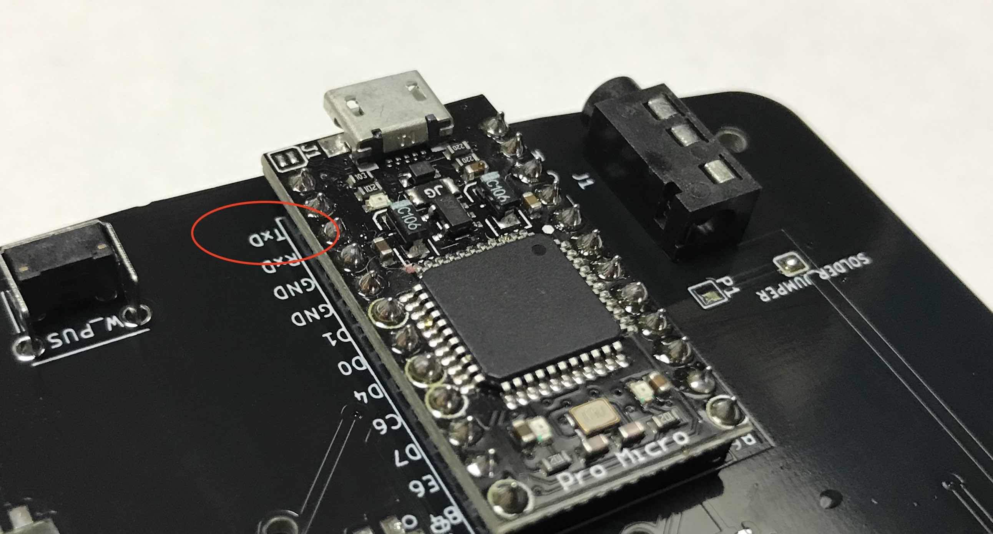
[picture p67: pictures/Con_throughSoldered2ProMicro.jpg]
  
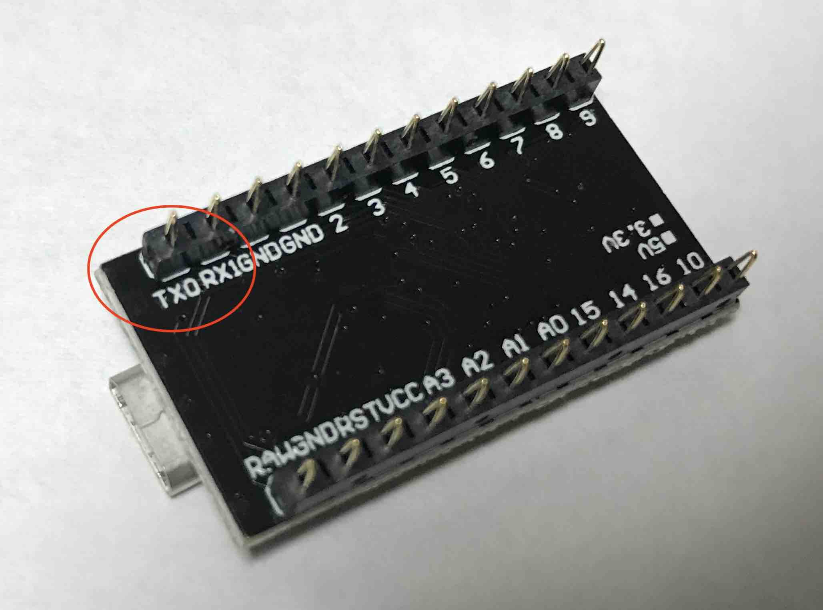
[picture p68: pictures/ProMicro_TxD_r01.jpg]


コンスルーを基板の裏面から差し、TxD の位置を見て向きが揃っていることを確認したら、コンスルーと Pro Micro を半田付けします。
**一度半田付けしたコンスルーを外すのは困難を極めますので、十分注意してください。**

## 7 ボトムプレート、スペーサーの組み立て
ボトムプレートの、図の赤丸の位置 10 箇所に M2 のねじで スペーサーを取り付けます。  
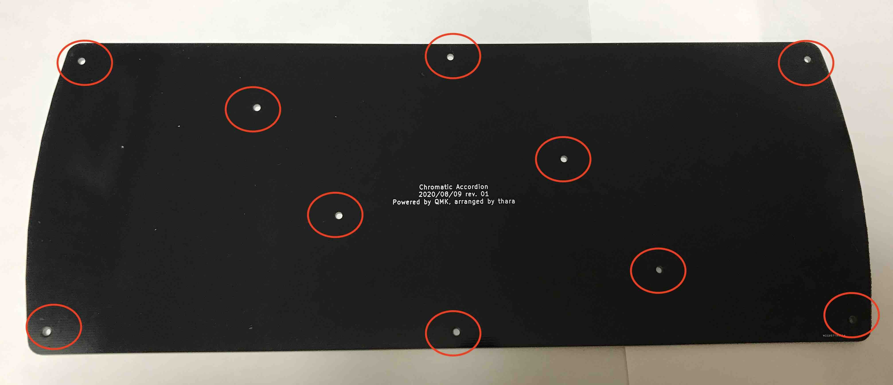
[picture p69: pictures/BottomPlate.jpg]
  
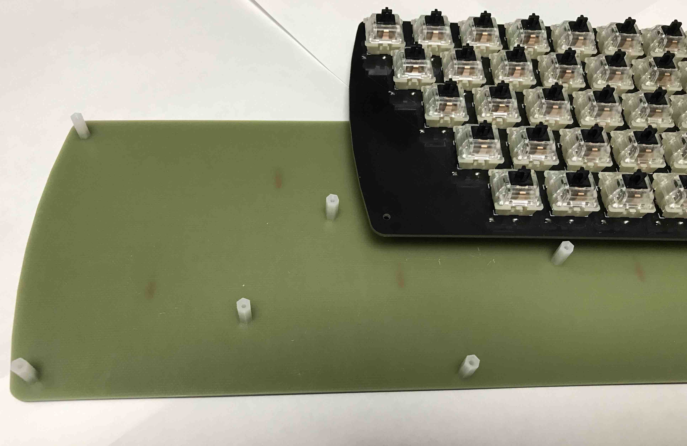
[picture p70: pictures/SpacerOnBottomPlate.jpg]
spacer


キースイッチの間にネジをセットするにはピンセットを使います。  
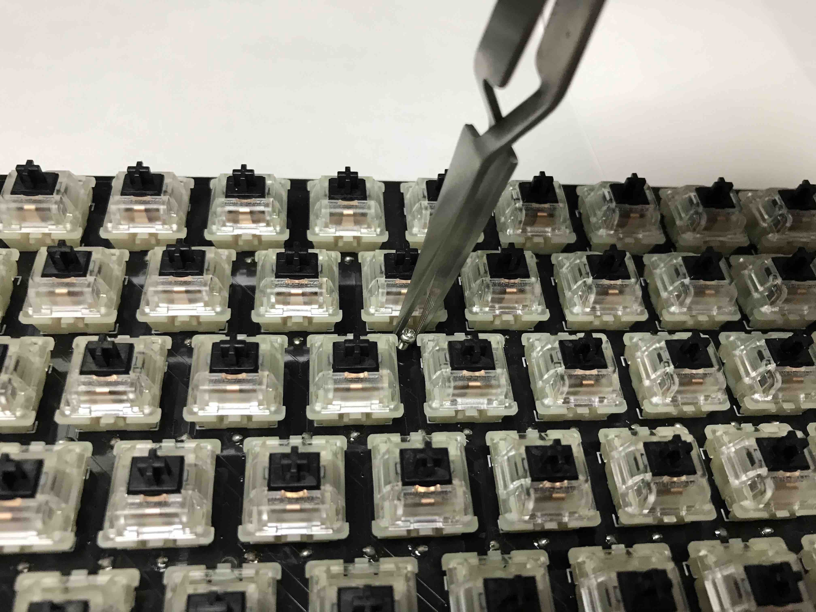
[picture p71: pictures/ScrewSettingWIthTweezers.jpg]


ネジ止めは、たすき掛けで均一に締めつけますが、強く締めつけすぎないようにします。

（左手側は、左上と右下の二箇所がキースイッチと干渉してしまって上からねじ止めができませんでした。。。すみません。）  
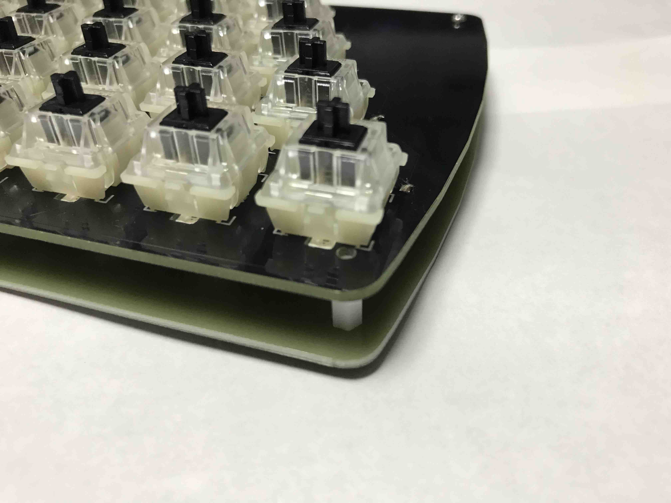
[picture p72: pictures/leftUpperLeftCorner.jpg]


緑丸の位置にクッションシールを取り付けます。  
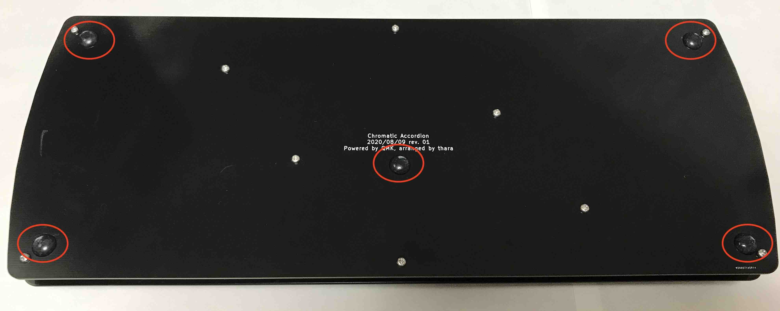
[picture p73: pictures/Cushon.jpg]
gom


## 8 Firmwareの書き込み
左右の基板の Pro Micro に同じHEXファイルを書き込みます。

### 8.1 コーディングはちょっと自信がない／とりあえず基本機能で動作させたい、という方 ###

コンパイル済のHEXファイルは[こちら](https://github.com/3araht/giabalanai/blob/main/giabalanai_3araht.hex)からダウンロードできます。
**サスティン問題対策版です♪**

初めての方はHEXファイルの書き込みに以下のツールを使うことをお勧めします。  
https://github.com/qmk/qmk_toolbox

QMK Toolbox の使い方（Win版） は サリチル酸さんの[記事](https://salicylic-acid3.hatenablog.com/entry/qmk-toolbox)がとても参考になります(サリチル酸さん、どうもありがとうございます)。

Macをご使用の方: インストール方法が違うだけで、基本的には同じです。

### 8.2 コーディングに慣れている方、チャレンジされる方 ###

以下を参考に書き込んでください。または、QMKで検索すると書き込み方がすぐに出てくるはずです。  
https://docs.qmk.fm/#/getting_started_build_tools

giabalanai の Firmware は以下にUPされるよう push request 中です。
https://github.com/qmk/qmk_firmware/tree/master/keyboards/giabalanai

それまで、暫定的に[こちら](https://github.com/3araht/giabalanai/blob/main/temp/qmk_firmware/keyboards/giabalanai)のソースコードをお使いください。

#### 8.2.1 暫定的にUPしたソースの使い方 ####
1. まず、qmk_firmware を clone してきます。
https://github.com/qmk/qmk_firmware

2. qmk_firmware/util/new_keyboard.sh を使って giabalanai キーボード を新規登録します。以下のコマンドでスクリプトを実行します。  
このコマンドは qmk_firmware フォルダで実行します。  
```
./util/new_keyboard.sh
```
下図の赤い文字にしたがって進めて行きます。こうすると、正式な手続きでgiabalanai キーボードのフォルダが qmk_firmware/keyboards に出来上がります。  
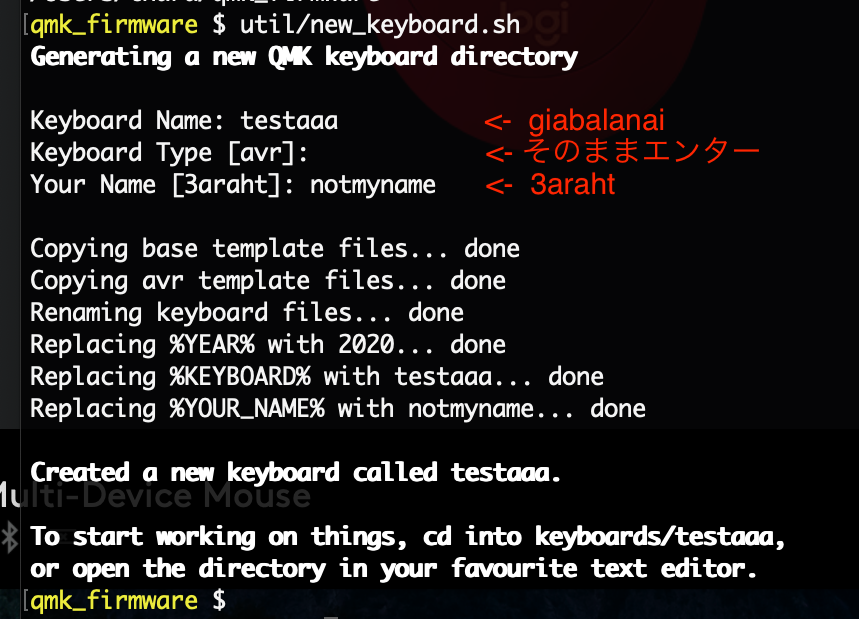
[picture p74: pictures/new_keyboard.png]
new_keyboard
  
また、これにより、qmk_firmware フォルダで  
```
make giabalanai:default
```
などのコンパイルも通るようになります。

3. 暫定的に UP している[こちら](https://github.com/3araht/giabalanai/blob/main/temp/qmk_firmware/keyboards/giabalanai)のソースコードを qmk_firmware/keyboards/giabalanai に上書き保存します。

4. サスティン問題回避  
MIDIソフトによっては、同じ音を重ねて鳴らしたときにその音にUSBケーブルを抜き差しするまでサスティンがかかってしまう現象がありました。
対策方法がわかりましたので、それを適用します（こちらも pull request 中。正式に採用されるまでの暫定対策）。  
以下の diff 結果を 参考に、 qmk_firmware/quantum/process_keycode/process_midi.c を修正してください。  
 → `if (tone_status[tone] == MIDI_INVALID_NOTE) {` `}`を追加します。

```
diff --git a/quantum/process_keycode/process_midi.c b/quantum/process_keycode/process_midi.c
index b2fb902eb..e52577014 100644
--- a/quantum/process_keycode/process_midi.c
+++ b/quantum/process_keycode/process_midi.c
@@ -68,10 +68,12 @@ bool process_midi(uint16_t keycode, keyrecord_t *record) {
             uint8_t tone     = keycode - MIDI_TONE_MIN;
             uint8_t velocity = compute_velocity(midi_config.velocity);
             if (record->event.pressed) {
-                uint8_t note = midi_compute_note(keycode);
-                midi_send_noteon(&midi_device, channel, note, velocity);
-                dprintf("midi noteon channel:%d note:%d velocity:%d\n", channel, note, velocity);
-                tone_status[tone] = note;
+                if (tone_status[tone] == MIDI_INVALID_NOTE) {
+                    uint8_t note = midi_compute_note(keycode);
+                    midi_send_noteon(&midi_device, channel, note, velocity);
+                    dprintf("midi noteon channel:%d note:%d velocity:%d\n", channel, note, velocity);
+                    tone_status[tone] = note;
+                }
             } else {
                 uint8_t note = tone_status[tone];
                 if (note != MIDI_INVALID_NOTE) {
```

5. カスタマイズ！  
~~かなり Staggered なので、このキーボードでタイピングすることはあまり考えていないと思いますが、必要に応じてカスタマイズしてお使いください。~~  
意外と打てました。左手側のキーボードを5x12の60％キーボードとして使えそうです。  
（また、register switch 機能を付与するなどのカスタマイズは面白いかもしれませんね。）

### 8.3 default について
**上記コンパイル済のHEXファイルは下記に示すdefault 設定に加えてLEDが実装されていれば押したキーのLED が発光するようになっています。**

USBケーブルを接続したら、アコーディオンの配列になります。

エンコーダを右に回すと音量が大きくなり、左に回すと小さくなるようになっています。
エンコーダは押しボタンにもなっており、押すとミュートON/OFFを切り替えるようになっています。

エンコーダボタン（短押しだとミュート）を長押しながら左手側キーボード 2行1列目のD♭Majorのコードのキーを押すと
左手側キーボード の5行12列がQWERTY配列のキーボード になるようになっています（マイナス記号など一部配置されていないので簡易的なものになります）。
アコーディオンの配列に戻す場合は、エンコーダボタンを長押しながら左手側キーボード 1行1列目のD♭のキーを押します。
なお、電源を再投入（USB抜き差し）したら
~~アコーディオンの配列（C-System）に戻ります。~~ 最後に使っていたアコーディオン配列に戻ります。

**ここからは上記コンパイル済のHEXファイルの場合**  
右手側下3行だけはB-systemにすることもできます。エンコーダーボタン長押し＋左手側キーボード 1行2列目のA♭のキーを押します（誤白川さん、アイデアありがとうございます）。

また、左手側のベース音を2列にした Counter Bass レイアウトにも変更可能です。エンコーダーボタン長押し＋左手側キーボード 1行3列目のE♭のキーを押します（チャラン・ポ・ランタン 小春さん、ご要望いただきありがとうございます）。

オクターブ調整もできるようになりました。

| 操作 | 変更先レイヤー（配列）  |
|---|---|
| エンコーダーボタン長押し＋左手側キーボード 1行1列目のD♭ | アコーディオン配列（C-System）＝初期状態|
| エンコーダーボタン長押し＋左手側キーボード 2行1列目のD♭Major | QWERTY 配列（左手側キーボード）|
| エンコーダーボタン長押し＋左手側キーボード 1行2列目のA♭ | アコーディオン配列（B-System、ただし下3行のみ)|
| エンコーダーボタン長押し＋左手側キーボード 1行3列目のE♭ | アコーディオン配列（C-System, Counter Bass版=dim コード無し）|
| エンコーダーボタン長押し＋左手側キーボード 1行12列目のF# | LED ON/OFF 切り替え（LED を実装している場合）|
|||
|エンコーダーボタン長押し＋右手側キーボード 3行1列目のG# | 2オクターブ低く|
|エンコーダーボタン長押し＋右手側キーボード 3行2列目のB | 1オクターブ低く|
|エンコーダーボタン長押し＋右手側キーボード 3行3列目のD | 基準の音階|
|エンコーダーボタン長押し＋右手側キーボード 3行4列目のF | 1オクターブ高く|
|エンコーダーボタン長押し＋右手側キーボード 3行5列目のG# | 2オクターブ高く|
| USB ケーブル抜き差し | 前回最後に使っていたアコーディオン配列に戻ります。オクターブは基準音階に戻ります。|

**このキーボードでは、右手側がマスターとなっていますので、USBケーブルは必ず右手側に接続してください。**

## 9 チェックポイント
簡単なチェック項目を挙げます。参考になれば幸いです。

- Pro Micro は左右の基板共にしっかり基板に刺さっている。
- Pro Micro のピンと基板のピンは一致させた状態で接続できている（Pro Micro の上下の向き確認）。
- Pro Micro にファームウェアを書き込んである（左右同じHEXファイルを書き込みます）。
- TRRS ケーブルはしっかり奥まで刺さっている（少しきついのでこれが問題となりがちです。ご注意ください。）
  また、TRRSケーブル内に 5V と GND 線が走っており、電源投入中に抜き差しするとショートする恐れがあるので、活線挿抜はお控えください。
- MIDI機器に対応したソフトを起動している。
- USBケーブルは右手側のキーボードに接続されている。
- 半田付けに問題はないか（ダイオードの向き、赤目、富士山、など）。

また、遊舎工房さんの[サポートサイト](https://yushakobo.zendesk.com/hc/ja)が参考になると思います。併せてご覧ください。
