3araht/giabalanai/(threads)

Thread 1 (2023-07-08):

Is there any option for B system ?

MeowLucian, 2023-07-08:
This project is fantastic !

I play the chromatic button accordion as well.

With this project I can practice the fingering without the the accordion during the short break time.

But my question is that "Is there any option for B system" ?

This project would be better if the layout and software support this option.

Thanks
Lucian

3araht, 2023-07-09:
Hi! Thanks!

Yes, there is.
If you're looking for B system, giabalanaipico, the Raspberry Pi Pico version, is for you.
https://github.com/3araht/giabalanaipico

giabalanai does have one layer for the B system, but I call it a "fake" B system because you can only use the bottom 3 rows.

On the other hand, you can assign any keys fully on the giabalanaipico's right-hand side.
B system is fully supported.
