3araht/giabalanai/(commit log)

2020-08-21 A pcb picture added.
2020-09-09 number of diode fixed.
2020-09-10 lift board solder updated
2020-09-23 Diode shortage problem updated.
2020-09-26 spacer instruction changed.
2020-10-14 comment added regarding LED soldering
2021-02-25 LED indicating _FN layer keys added to giabaRInaix2led keymap.c.
2021-03-21 Pitch Bender keys added to C_SYSTEM_ENTIRELY.
2021-03-24 LED check topics added.
2021-04-01 MicroUSB cable recommendation modified.
2021-04-03 Definition MIDI_TONE_KEYCODE_OCTAVES modified from 5 to 6, Pitch Bender added to 2firmware as well.
2021-04-08 PRODUCT ID of giabaRInaix2 has been unified to lower case.
2021-04-12 1, Melody switch added (root_note + lower octave), (root_note + higher octave), root_note. 2, (fixed) Base Key LED doesn't turn on when pressed.
2021-04-13 1, Set Max velocity to 117 in order to avoid using 127. 2, Velocity of the Unison octave notes are supressed to root note velocity - 30. 3, add option to toggle the velocity, 4, MI_VELD akd MI_VELU a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
2021-04-17 party mode added for LED debugging.party mode added for LED debugging.party mode added for LED debugging.party mode added for LED debugging.party mode added for LED debugging.party mode added for LED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
2021-04-18 LED brightness has lowered to 80. LED color is depending on default layer, etc.
2021-05-07 Switch plate added to build guide.
2021-05-22 HSV_DARK* deleted. LED_HITS_TO_REMEMBER is now 10. PARTY_REACTIVE_FOCUSED_MODE added to party.
2021-05-23 日本語表記追加。
2021-05-24 LED check with multimeter is not that easy.
2021-06-08 encoder_update_user() definition changed. json file updated.
2021-07-10 Encoder is now customizable from REMAP.
2021-07-11 Encoder codes moved to giabalanai.c
2021-07-17 Party rocks (fake faulty LED soldering) mode added, etc.
2021-11-24 Drashna's method is applied to rotary encoder rotation detection.
2022-08-31 qmk 0.18.1 updated. Encoder fix.
